HeyPCB/whisker/cad/board_on_cradle_under.png

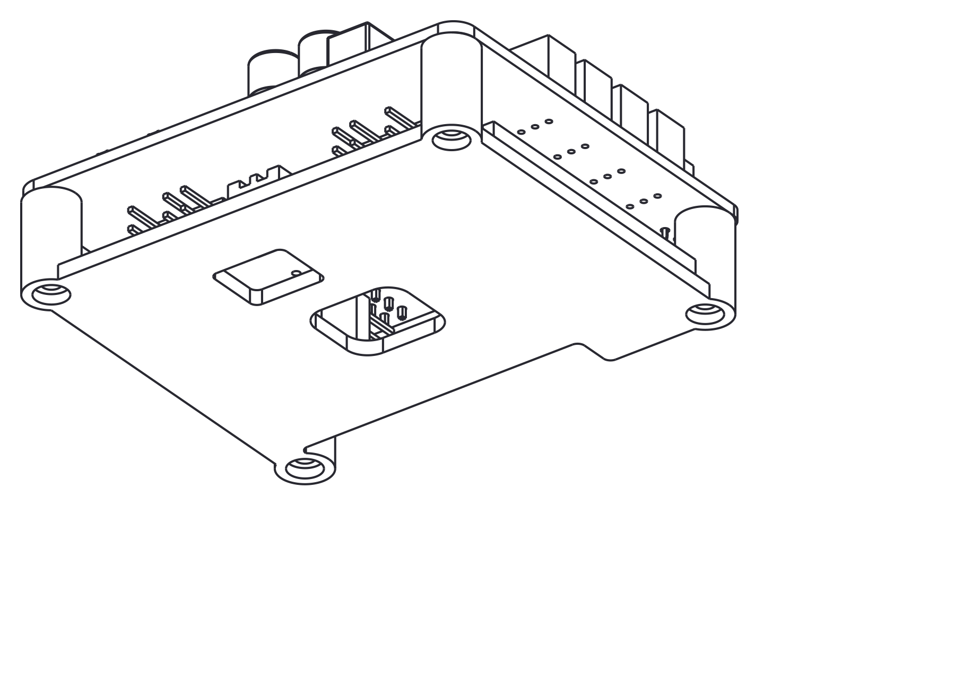
cad/board_on_cradle_under.png
