HeyPCB/whisker/cad/cradle_iso.png

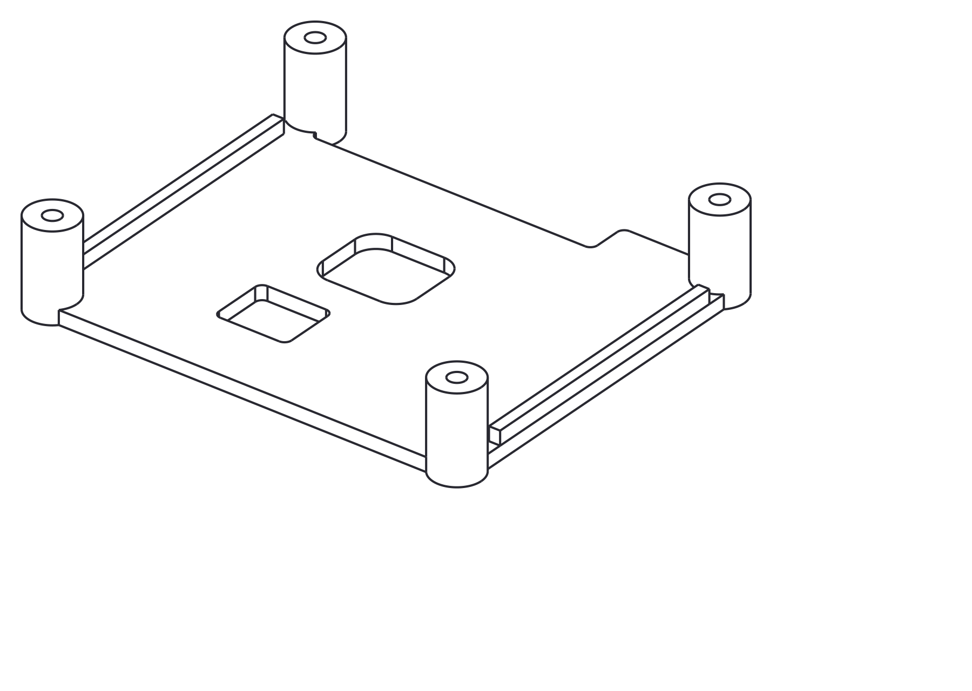
cad/cradle_iso.png
