HeyPCB/whisker/cad/cradle_top.png

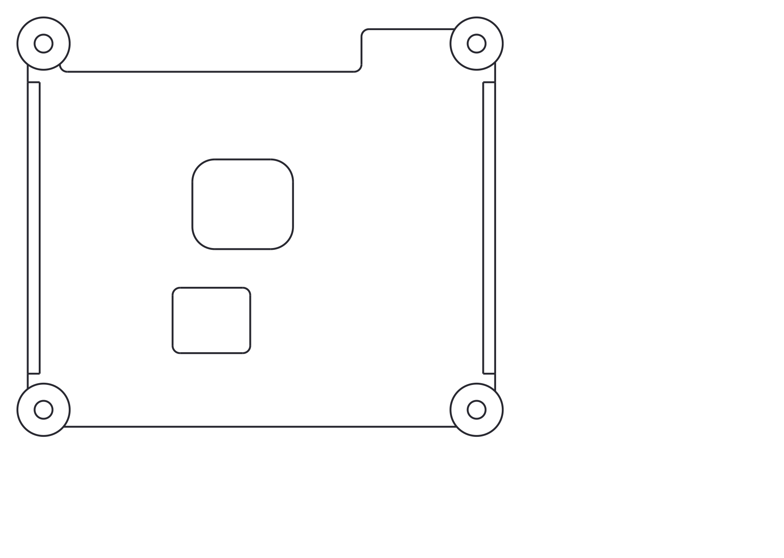
cad/cradle_top.png
