HeyPCB/whisker/cad/fit_end.png

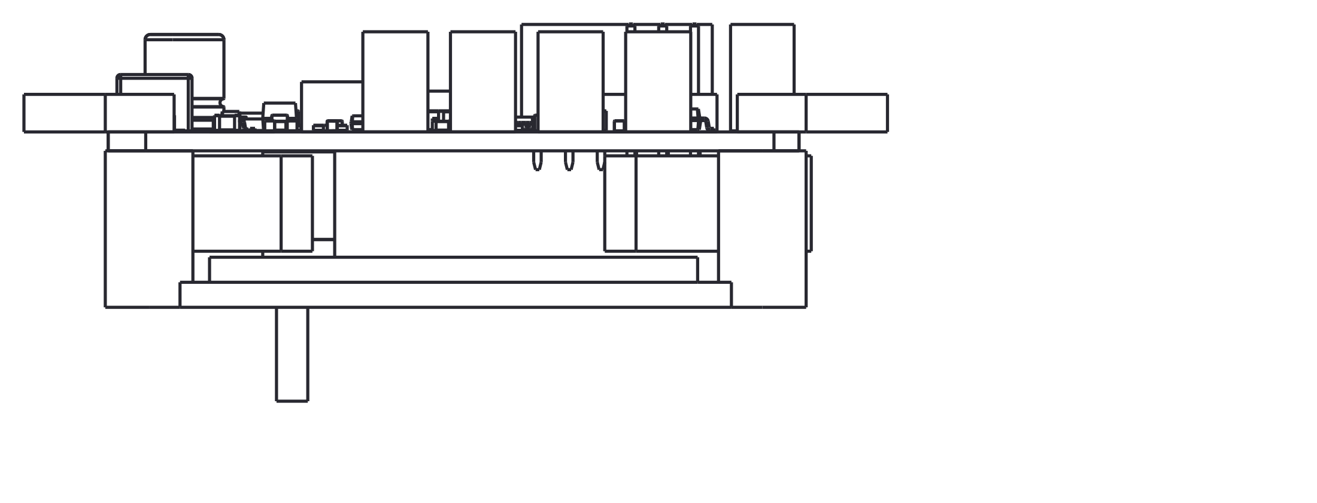
cad/fit_end.png
