HeyPCB/whisker/cad/fit_iso.png

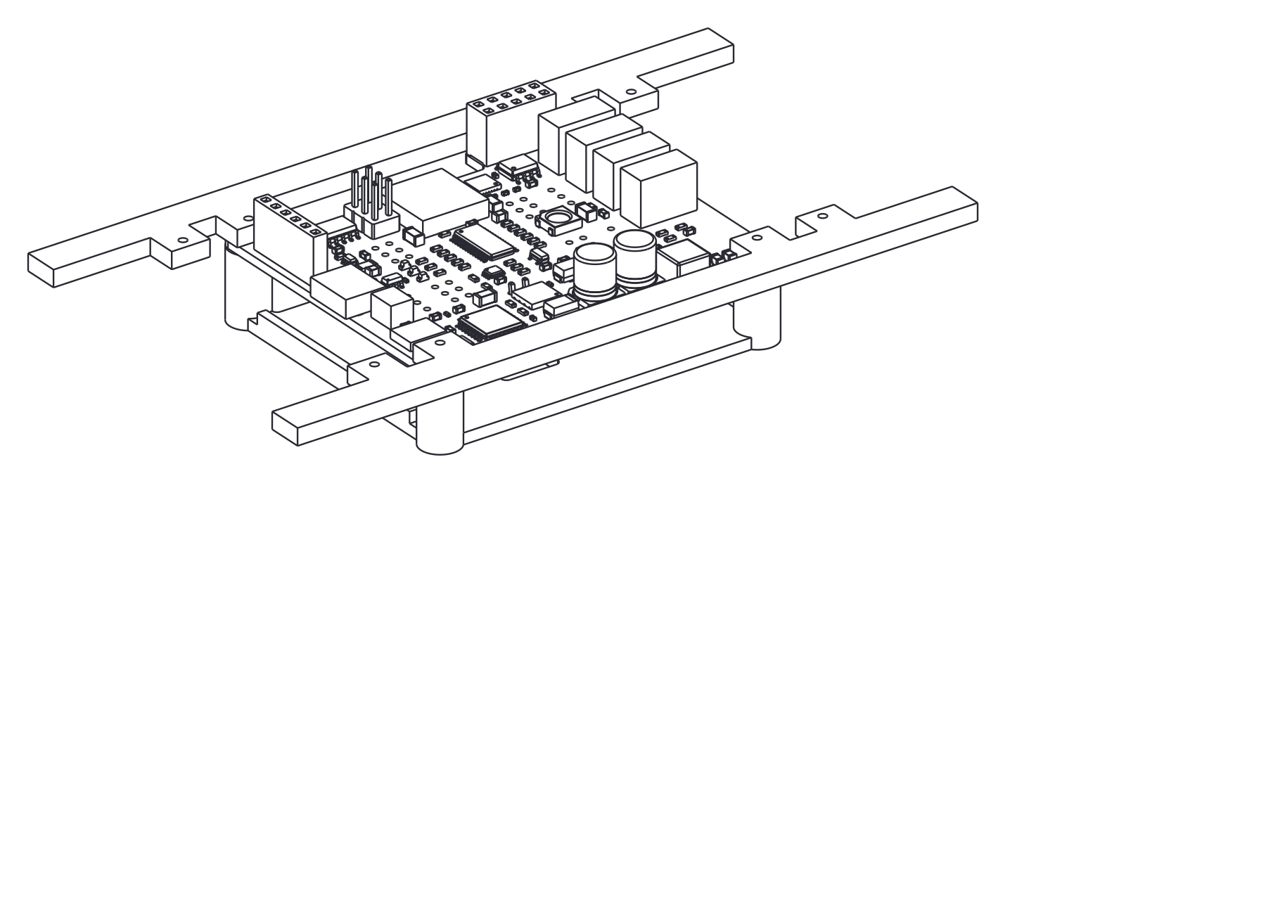
cad/fit_iso.png
