HeyPCB/whisker/cad/fit_side.png

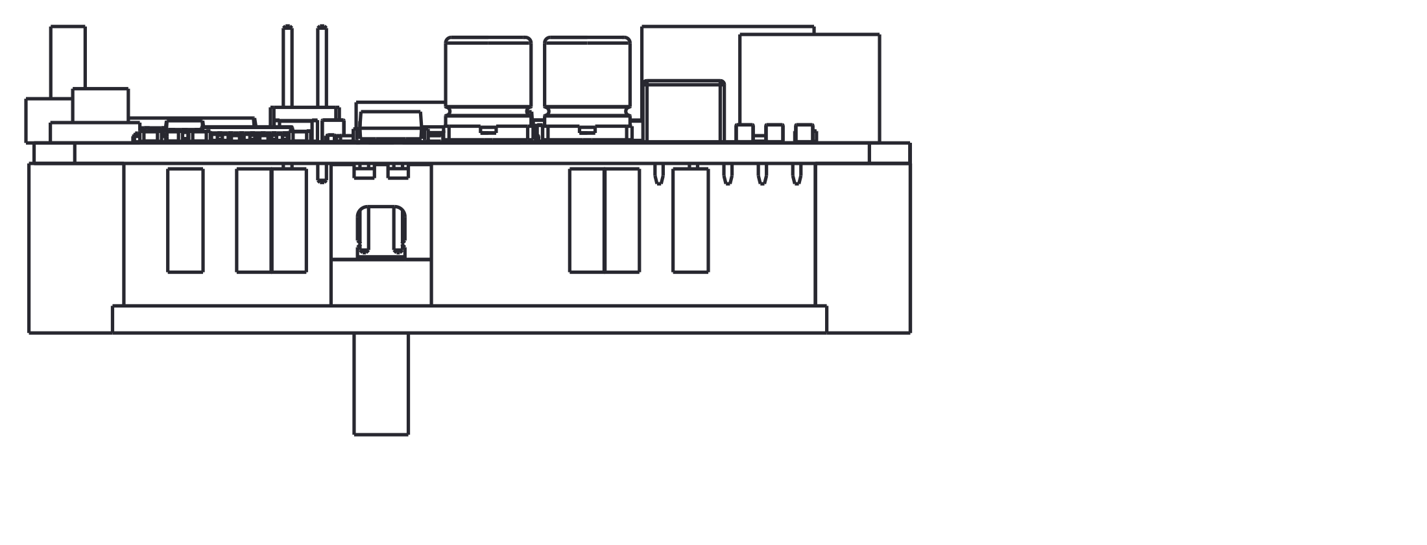
cad/fit_side.png
