HeyPCB/whisker/media/bottom.png

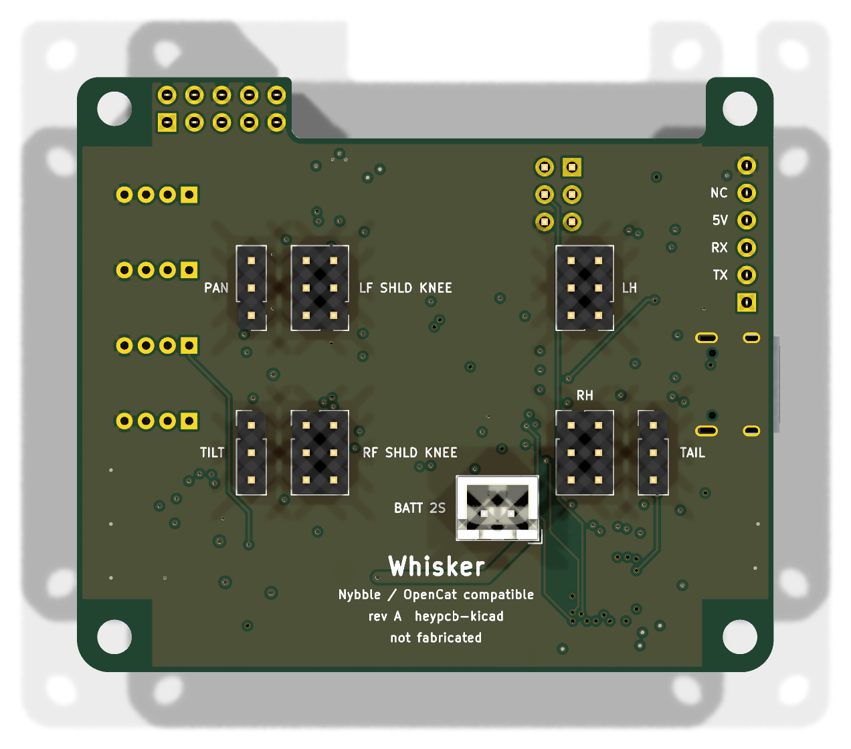
media/bottom.png
