HeyPCB/whisker/media/top.png

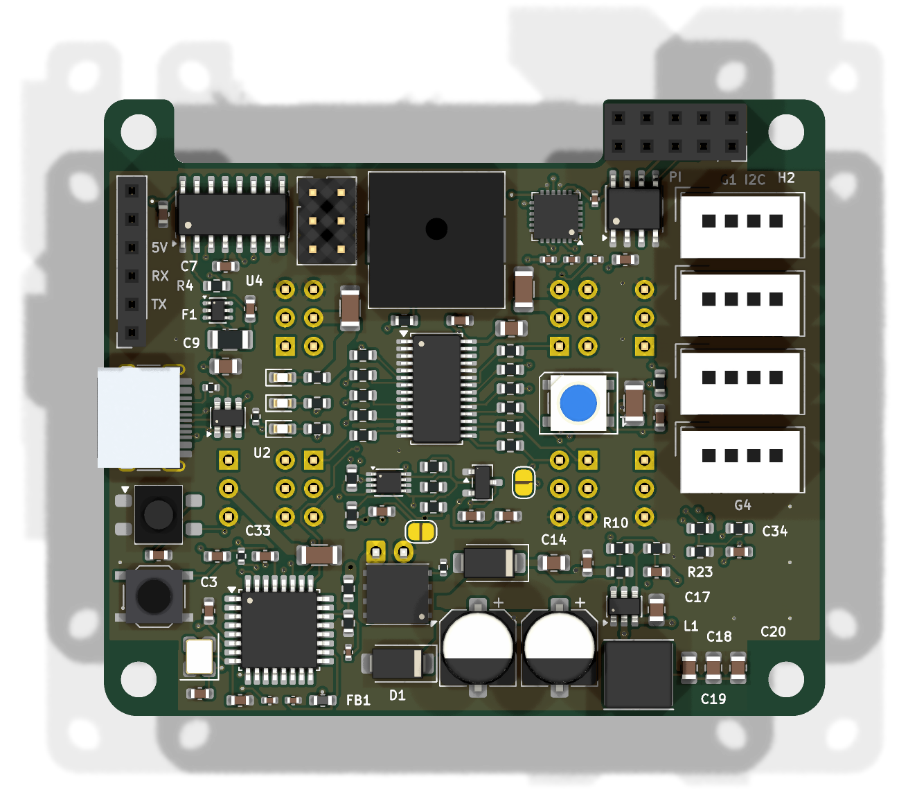
media/top.png
