HeyPCB/whisker/fab/whisker_bom.csv

Reference | Value | Footprint | MPN | LCSC | Qty
BZ1 | PKLCS1212E4001 | Buzzer_Beeper:Buzzer_Murata_PKLCS1212E | PKLCS1212E4001-R1 | C113159 | 1
C1,C2 | 12pF | Capacitor_SMD:C_0603_1608Metric | CL10C120JB8NNNC | C38523 | 2
C3,C6,C7,C8,C16,C17,C23,C24,C31,C32,C33,C34 | 100nF | Capacitor_SMD:C_0603_1608Metric | CC0603KRX7R9BB104 | C14663 | 12
C4,C5,C13,C26,C28,C30 | 100nF | Capacitor_SMD:C_0402_1005Metric | CL05B104KO5NNNC | C1525 | 6
C9,C25 | 10uF | Capacitor_SMD:C_0805_2012Metric | CL21A106KAYNNNE | C15850 | 2
C10,C21,C22 | 1uF | Capacitor_SMD:C_0603_1608Metric | CL10A105KB8NNNC | C15849 | 3
C11,C12 | 330uF 25V | Capacitor_SMD:CP_Elec_6.3x7.7 | 189RV0016 | C7471878 | 2
C14,C15,C18,C19,C20 | 22uF | Capacitor_SMD:C_0805_2012Metric | CL21A226MAQNNNE | C45783 | 5
C27 | 10nF | Capacitor_SMD:C_0402_1005Metric | CL05B103KB5NNNC | C15195 | 1
C29 | 2.2nF | Capacitor_SMD:C_0603_1608Metric | 0603B222K500NT | C1604 | 1
C35,C36,C37,C38 | 10uF | Capacitor_SMD:C_1206_3216Metric | CL31A106KBHNNNE | C13585 | 4
D1 | SMAJ10A | Diode_SMD:D_SMA | SMAJ10A | C908764 | 1
D2 | SS34 | Diode_SMD:D_SMA | SS34 | C8678 | 1
D3 | Orange (BAT) | LED_SMD:LED_0603_1608Metric | XL-1608UOC-06 | C965800 | 1
D4 | WS2812B | LED_SMD:LED_WS2812B_PLCC4_5.0x5.0mm_P3.2mm | WS2812B-B/T | C2761795 | 1
D5 | Green (D3) | LED_SMD:LED_0603_1608Metric | KT-0603G | C12624 | 1
D6 | Blue (5V) | LED_SMD:LED_0603_1608Metric | NCD0603B1 | C84266 | 1
F1 | 500mA | Fuse:Fuse_1206_3216Metric | 1206L050/30NR | C7542947 | 1
FB1 | 120R@100MHz | Inductor_SMD:L_0603_1608Metric | BLM18PG121SN1D | C14709 | 1
J1 | ICSP | Connector_PinHeader_2.54mm:PinHeader_2x03_P2.54mm_Vertical | PZ254V-12-6P | C492420 | 1
J2 | USB-C | Connector_USB:USB_C_Receptacle_HRO_TYPE-C-31-M-12 | TYPE-C-31-M-12 | C165948 | 1
J3 | BATT 2S | Connector_JST:JST_XH_B2B-XH-A_1x02_P2.50mm_Vertical | B2B-XH-A(LF)(SN) | C158012 | 1
J4,J5,J6,J7 | GROVE | Connector:NS-Tech_Grove_1x04_P2mm_Vertical | ZX-HY2.0-4PZZ | C7429580 | 4
J8 | SERIAL | Connector_PinSocket_2.54mm:PinSocket_1x06_P2.54mm_Vertical | 2.54-1*6P母 | C40877 | 1
J9 | RPI 1-10 | Connector_PinSocket_2.54mm:PinSocket_2x05_P2.54mm_Vertical | PM254V-12-10P-H85 | C492399 | 1
J10,J14,J16 | SERVO (3-row R/A) | Connector_PinHeader_2.54mm:PinHeader_1x03_P2.54mm_Vertical | PZ254-3-03-W-2.5-G0 | C7429379 | 3
J11,J12,J13,J15 | SERVO x2 (3-row R/A) | Connector_PinHeader_2.54mm:PinHeader_2x03_P2.54mm_Vertical | PZ254-3-03-W-2.5-G0 | C7429379 | 4
L1 | 4.7uH | Inductor_SMD:L_Sunlord_SWPA6045S | SWPA6045S4R7MT | C78804 | 1
Q1 | AON6411 | Package_DFN_QFN:AO_DFN-8-1EP_5.55x5.2mm_P1.27mm_EP4.12x4.6mm | AON6411 | C81007 | 1
R1,R5 | 10k | Resistor_SMD:R_0402_1005Metric | 0402WGF1002TCE | C25744 | 2
R2,R3 | 5.1k | Resistor_SMD:R_0402_1005Metric | 0402WGF5101TCE | C25905 | 2
R4,R19,R20,R21,R22,R24,R25,R26,R27,R28,R29,R30,R31,R32,R33,R34 | 1k | Resistor_SMD:R_0603_1608Metric | 0603WAF1001T5E | C21190 | 16
R6 | 4.7k | Resistor_SMD:R_0603_1608Metric | 0603WAF4701T5E | C23162 | 1
R7,R8 | 20k | Resistor_SMD:R_0603_1608Metric | 0603WAF2002T5E | C4184 | 2
R9 | 82k | Resistor_SMD:R_0603_1608Metric | 0603WAF8202T5E | C23254 | 1
R10 | 15k | Resistor_SMD:R_0603_1608Metric | 0603WAF1502T5E | C22809 | 1
R11 | 100k | Resistor_SMD:R_0603_1608Metric | 0603WAF1003T5E | C25803 | 1
R12 | 200k | Resistor_SMD:R_0603_1608Metric | 0603WAF2003T5E | C25811 | 1
R13,R14,R15,R16 | 2.2k | Resistor_SMD:R_0603_1608Metric | 0603WAF2201T5E | C4190 | 4
R17 | 100 | Resistor_SMD:R_0603_1608Metric | 0603WAF1000T5E | C22775 | 1
R18 | 330 | Resistor_SMD:R_0603_1608Metric | 0603WAF3300T5E | C23138 | 1
R23 | 2k | Resistor_SMD:R_0603_1608Metric | 0603WAF2001T5E | C22975 | 1
SW1 | RESET | Button_Switch_SMD:SW_Push_1P1T_XKB_TS-1187A | TS-1187A-B-A-B | C318884 | 1
U1 | ATmega328P-AU | Package_QFP:TQFP-32_7x7mm_P0.8mm | ATMEGA328P-AU | C14877 | 1
U2 | USBLC6-2SC6 | Package_TO_SOT_SMD:SOT-23-6 | USBLC6-2SC6 | C7519 | 1
U3 | CH340C | Package_SO:SOIC-16_3.9x9.9mm_P1.27mm | CH340C | C84681 | 1
U4 | LM66100 | Package_TO_SOT_SMD:SOT-363_SC-70-6 | LM66100DCKR | C2869734 | 1
U5 | TPS563201 | Package_TO_SOT_SMD:SOT-23-6 | TPS563201DDCR | C116592 | 1
U6 | XC6206P332MR | Package_TO_SOT_SMD:SOT-23-3 | XC6206P332MR-G | C5446 | 1
U7 | PCA9306 | Package_SO:VSSOP-8_2.3x2mm_P0.5mm | PCA9306DCUR | C33196 | 1
U8 | PCA9685PW | Package_SO:TSSOP-28_4.4x9.7mm_P0.65mm | PCA9685PW,118 | C2678753 | 1
U9 | MPU-6050 | Sensor_Motion:InvenSense_QFN-24_4x4mm_P0.5mm | MPU-6050 | C24112 | 1
U10 | AT24C64D | Package_SO:SOIC-8_3.9x4.9mm_P1.27mm | AT24C64D-SSHM-T | C6487 | 1
U11 | IRM-H638T | OptoDevice:Everlight_IRM-H6xxT | IRM-H638T/TR2 | C91447 | 1
Y1 | 16MHz | Crystal:Crystal_SMD_3225-4Pin_3.2x2.5mm | X322516MLB4SI | C13738 | 1
