HeyPCB/whisker/cad/whisker_with_cradle.step

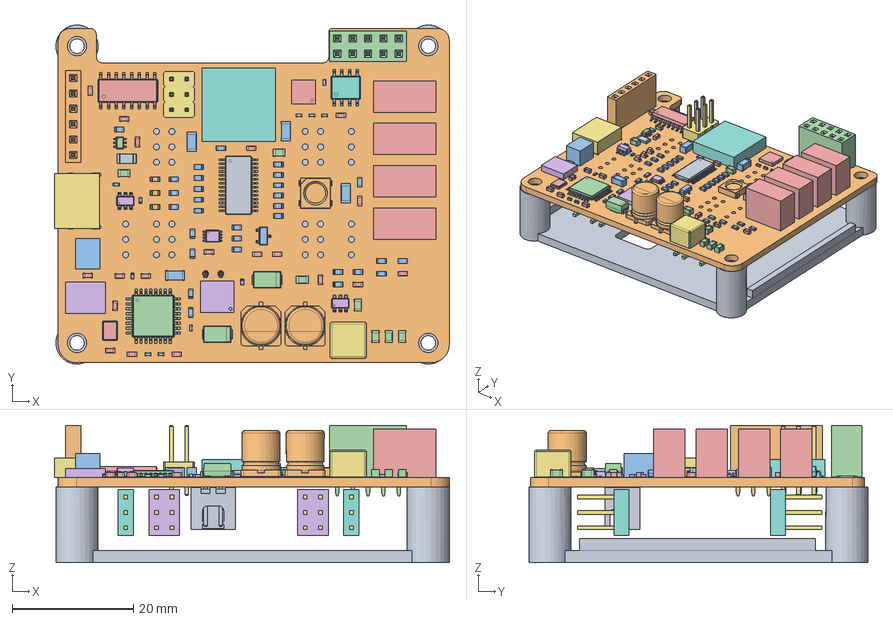
[picture p12: CAD file, 2026-10-03]
cad/whisker_with_cradle.step
65.2 x 56.0 x 22.6 mm
