HeyPCB/whisker/fab/whisker.step

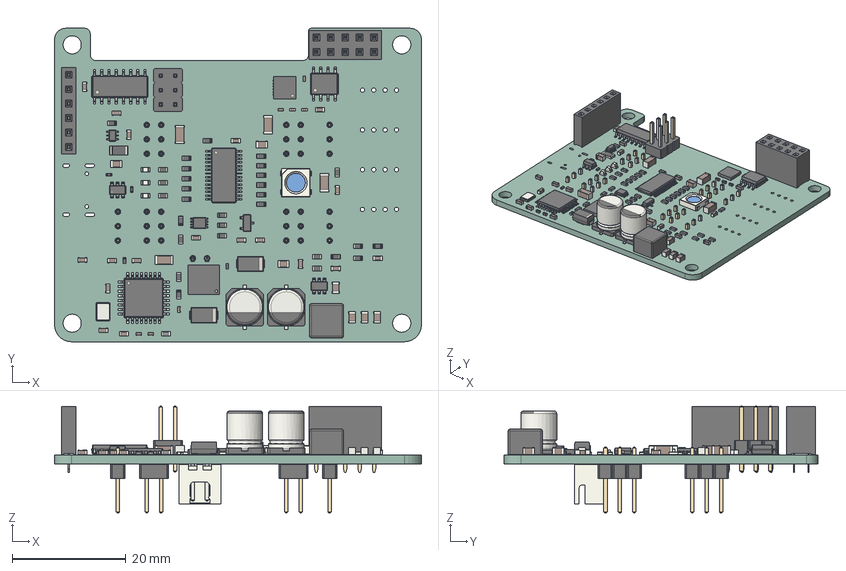
[picture p13: CAD file, 2026-10-03]
fab/whisker.step
64.6 x 55.2 x 18.8 mm
R_0603_1608Metric x 30
TQFP-32_7x7mm_P0.8mm
SOT-23-6 x 2
a6c163e6-8551-11ed-a139-00155d22e2d7_part
a6c16512-8551-11ed-a139-00155d22e2d7_part
a6c16594-8551-11ed-a139-00155d22e2d7_part
C_0402_1005Metric x 7
LED_WS2812B_PLCC4_50x50mm_P32mm
R_0402_1005Metric x 4
PinSocket_2x05_P2.54mm_Vertical
C_0603_1608Metric x 18
VSSOP-8_2.3x2mm_P0.5mm
Fuse_1206_3216Metric
LED_0603_1608Metric x 3
SOT-23-3
D_SMA x 2
L_0603_1608Metric
Crystal_SMD_3225-4Pin_3.2x2.5mm
PinHeader_2x03_P254mm_Vertical x 5
SOIC-8_3.9x4.9mm_P1.27mm
TSSOP-28_4.4x9.7mm_P0.65mm
CP_Elec_63x77 x 2
C_0805_2012Metric x 7
SOIC-16_3.9x9.9mm_P1.27mm
a4dc038a-92ba-11ed-bd60-83025610b399_part
a4dc038b-92ba-11ed-bd60-83025610b399_part
a4dc038c-92ba-11ed-bd60-83025610b399_part
a4dc038d-92ba-11ed-bd60-83025610b399_part
PinSocket_1x06_P2.54mm_Vertical
C_1206_3216Metric x 4
SOT-363_SC-70-6
QFN-24-1EP_4x4mm_P0.5mm_EP2.7x2.7mm
PinHeader_1x03_P254mm_Vertical x 3
JST_B2B_XH_A
whisker_PCB
