HeyPCB/whisker/cad/whisker_cradle.step

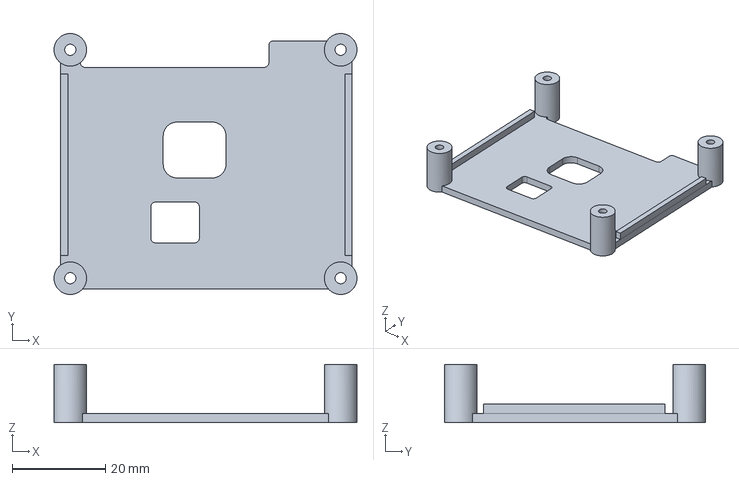
[picture p14: CAD file, 2026-10-03]
cad/whisker_cradle.step
65.0 x 56.0 x 12.5 mm
