HeyPCB/whisker/(list of files, cad)

Other CAD files:
cad/whisker_cradle.stl
