HeyPCB/whisker/fab/whisker_schematic.pdf

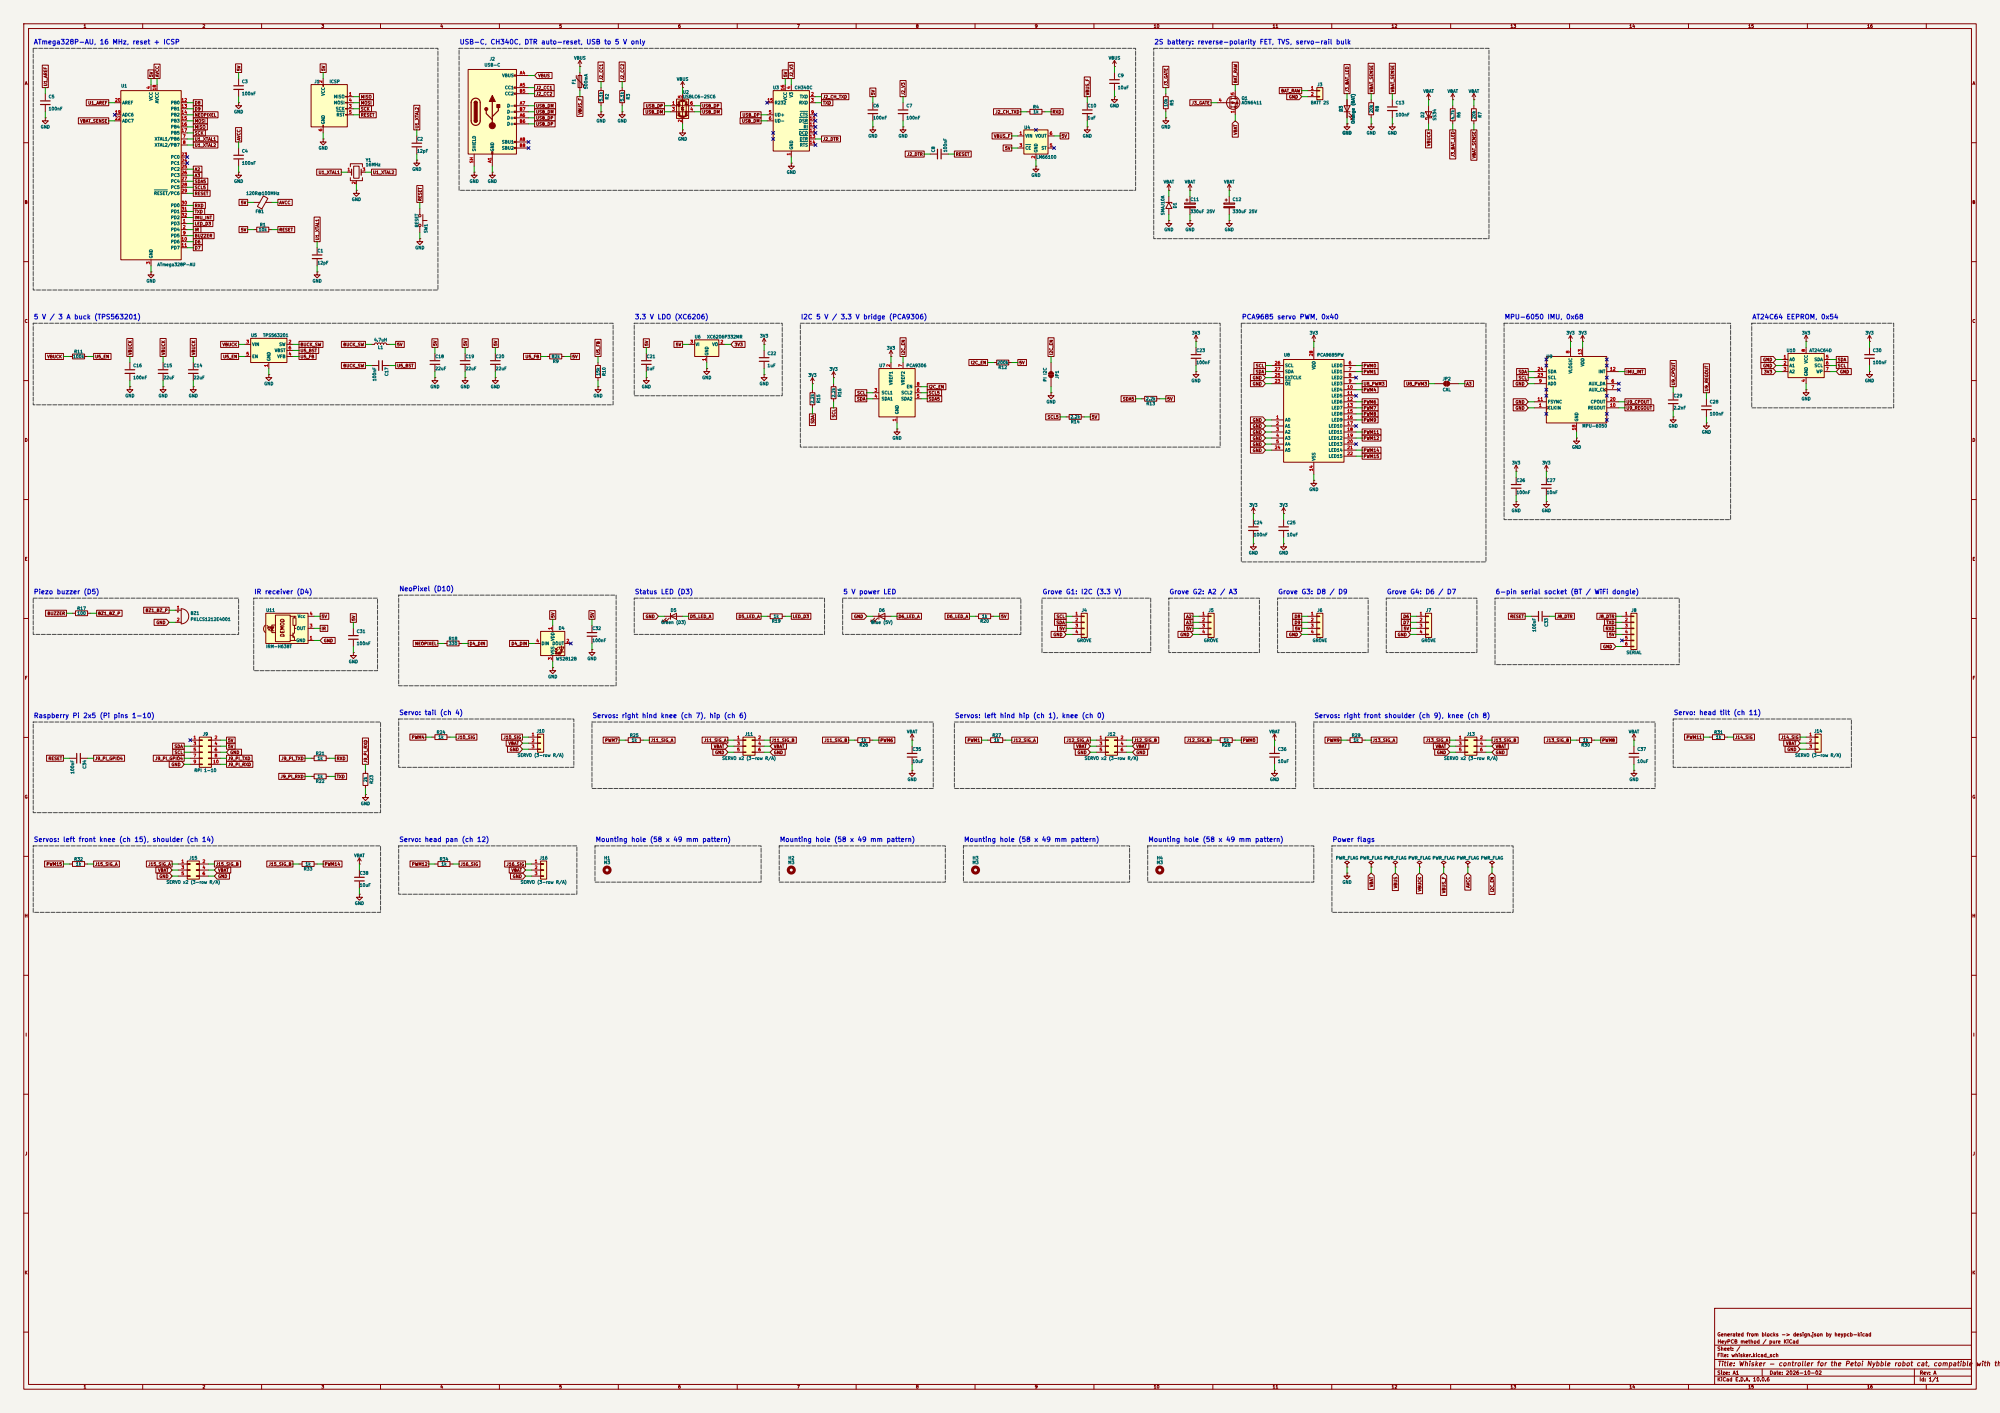
[picture p15: page 1]

ATmega328P-AU, 16 MHz, reset + ICSP

USB-C, CH340C, DTR auto-reset, USB to 5 V only
VBUS USB_DM

2S battery: reverse-polarity FET, TVS, servo-rail bulk
VBAT VBUS_F 5V

4 UD+ 5 UD- 6 CTS 9 DSR 10 RI 11 DCD 12 DTR 13 RTS 14 R232 15 VCC U3 16CH340C

Raspberry Pi 2x5 (Pi pins 1-10)

Servos: right front shoulder (ch 9), knee (ch 8)

Servo: head tilt (ch 11)

Servos: left front knee (ch 15), shoulder (ch 14)

Servo: head pan (ch 12)

Mounting hole (58 x 49 mm pattern)

Generated from blocks -> design.json by heypcb-kicad
HeyPCB method / pure KiCad
Sheet: /
File: whisker.kicad_sch
Title: Whisker - controller for the Petoi Nybble robot cat, compatible with the OpenCat firmware

Size: A1 | Rev: A
KiCad E.D.A. 10.0.6 | Id: 1/1
