HeyPCB/whisker/kicad/whisker.kicad_pcb

## KiCad design kicad/whisker.kicad_pcb (2026-10-03)

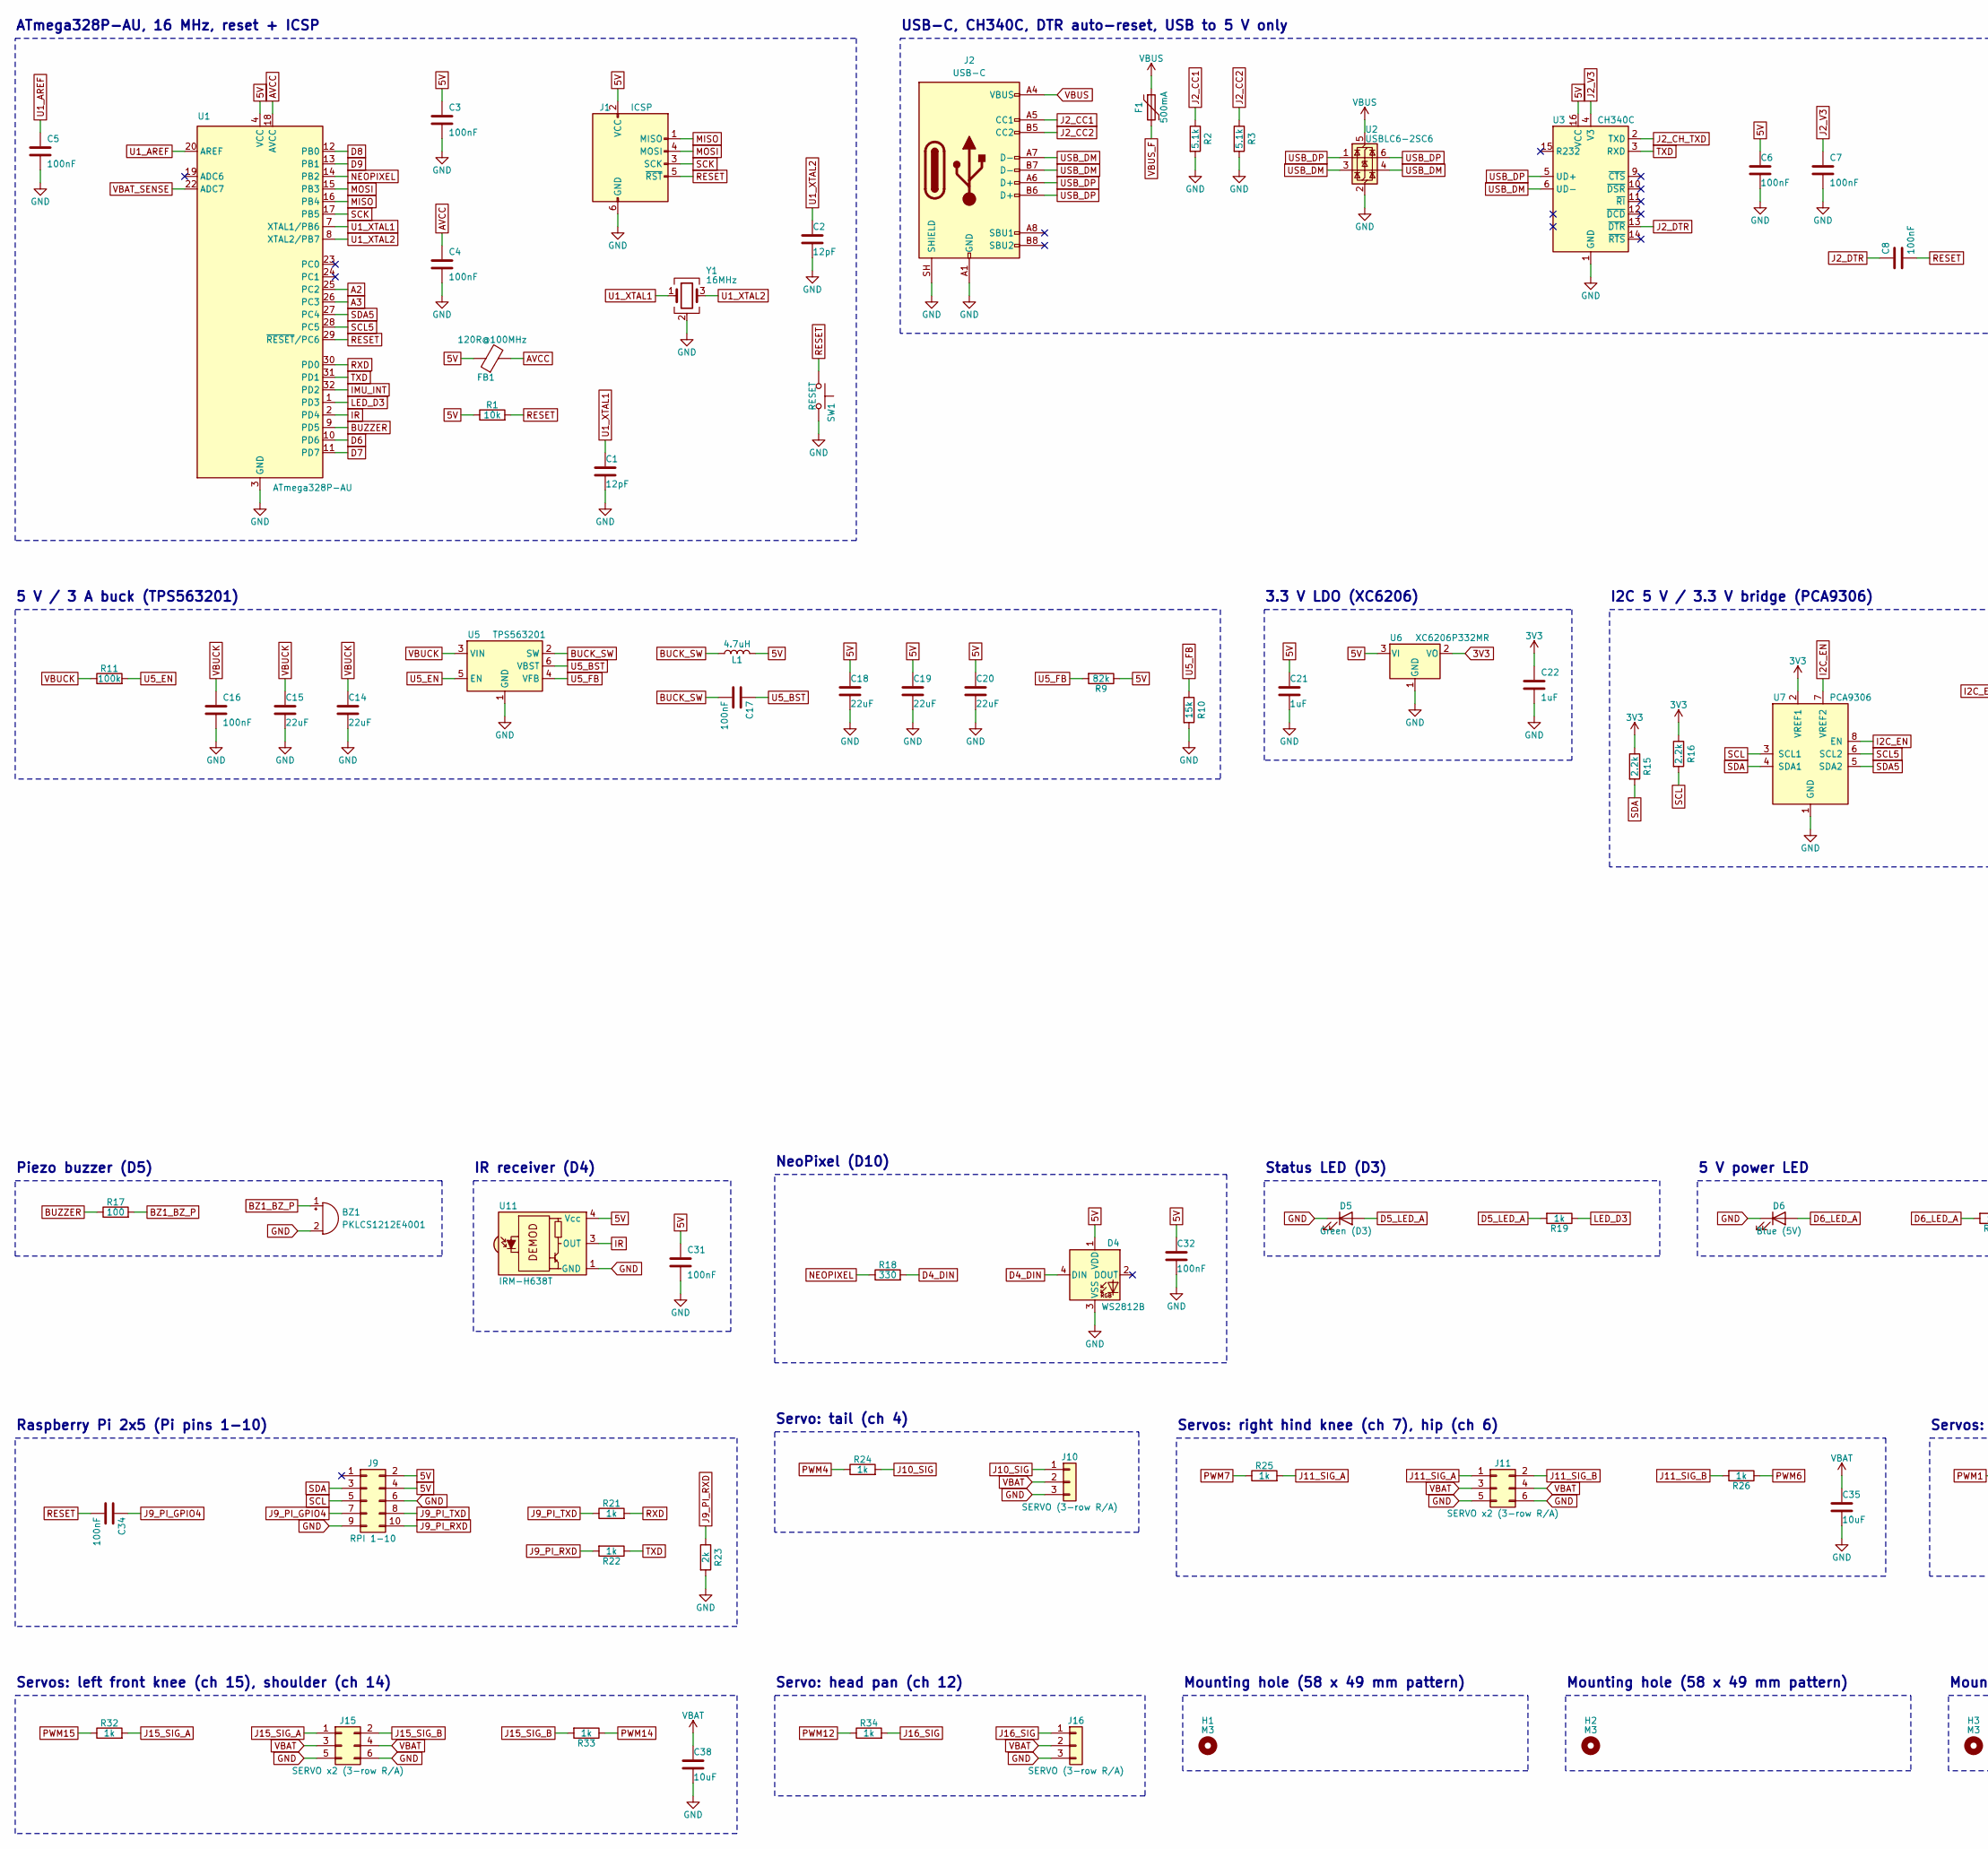
[picture p16: schematic whisker.kicad_sch, Whisker - controller for the Petoi Nybble robot cat, compat…, part in row 1, column 1]

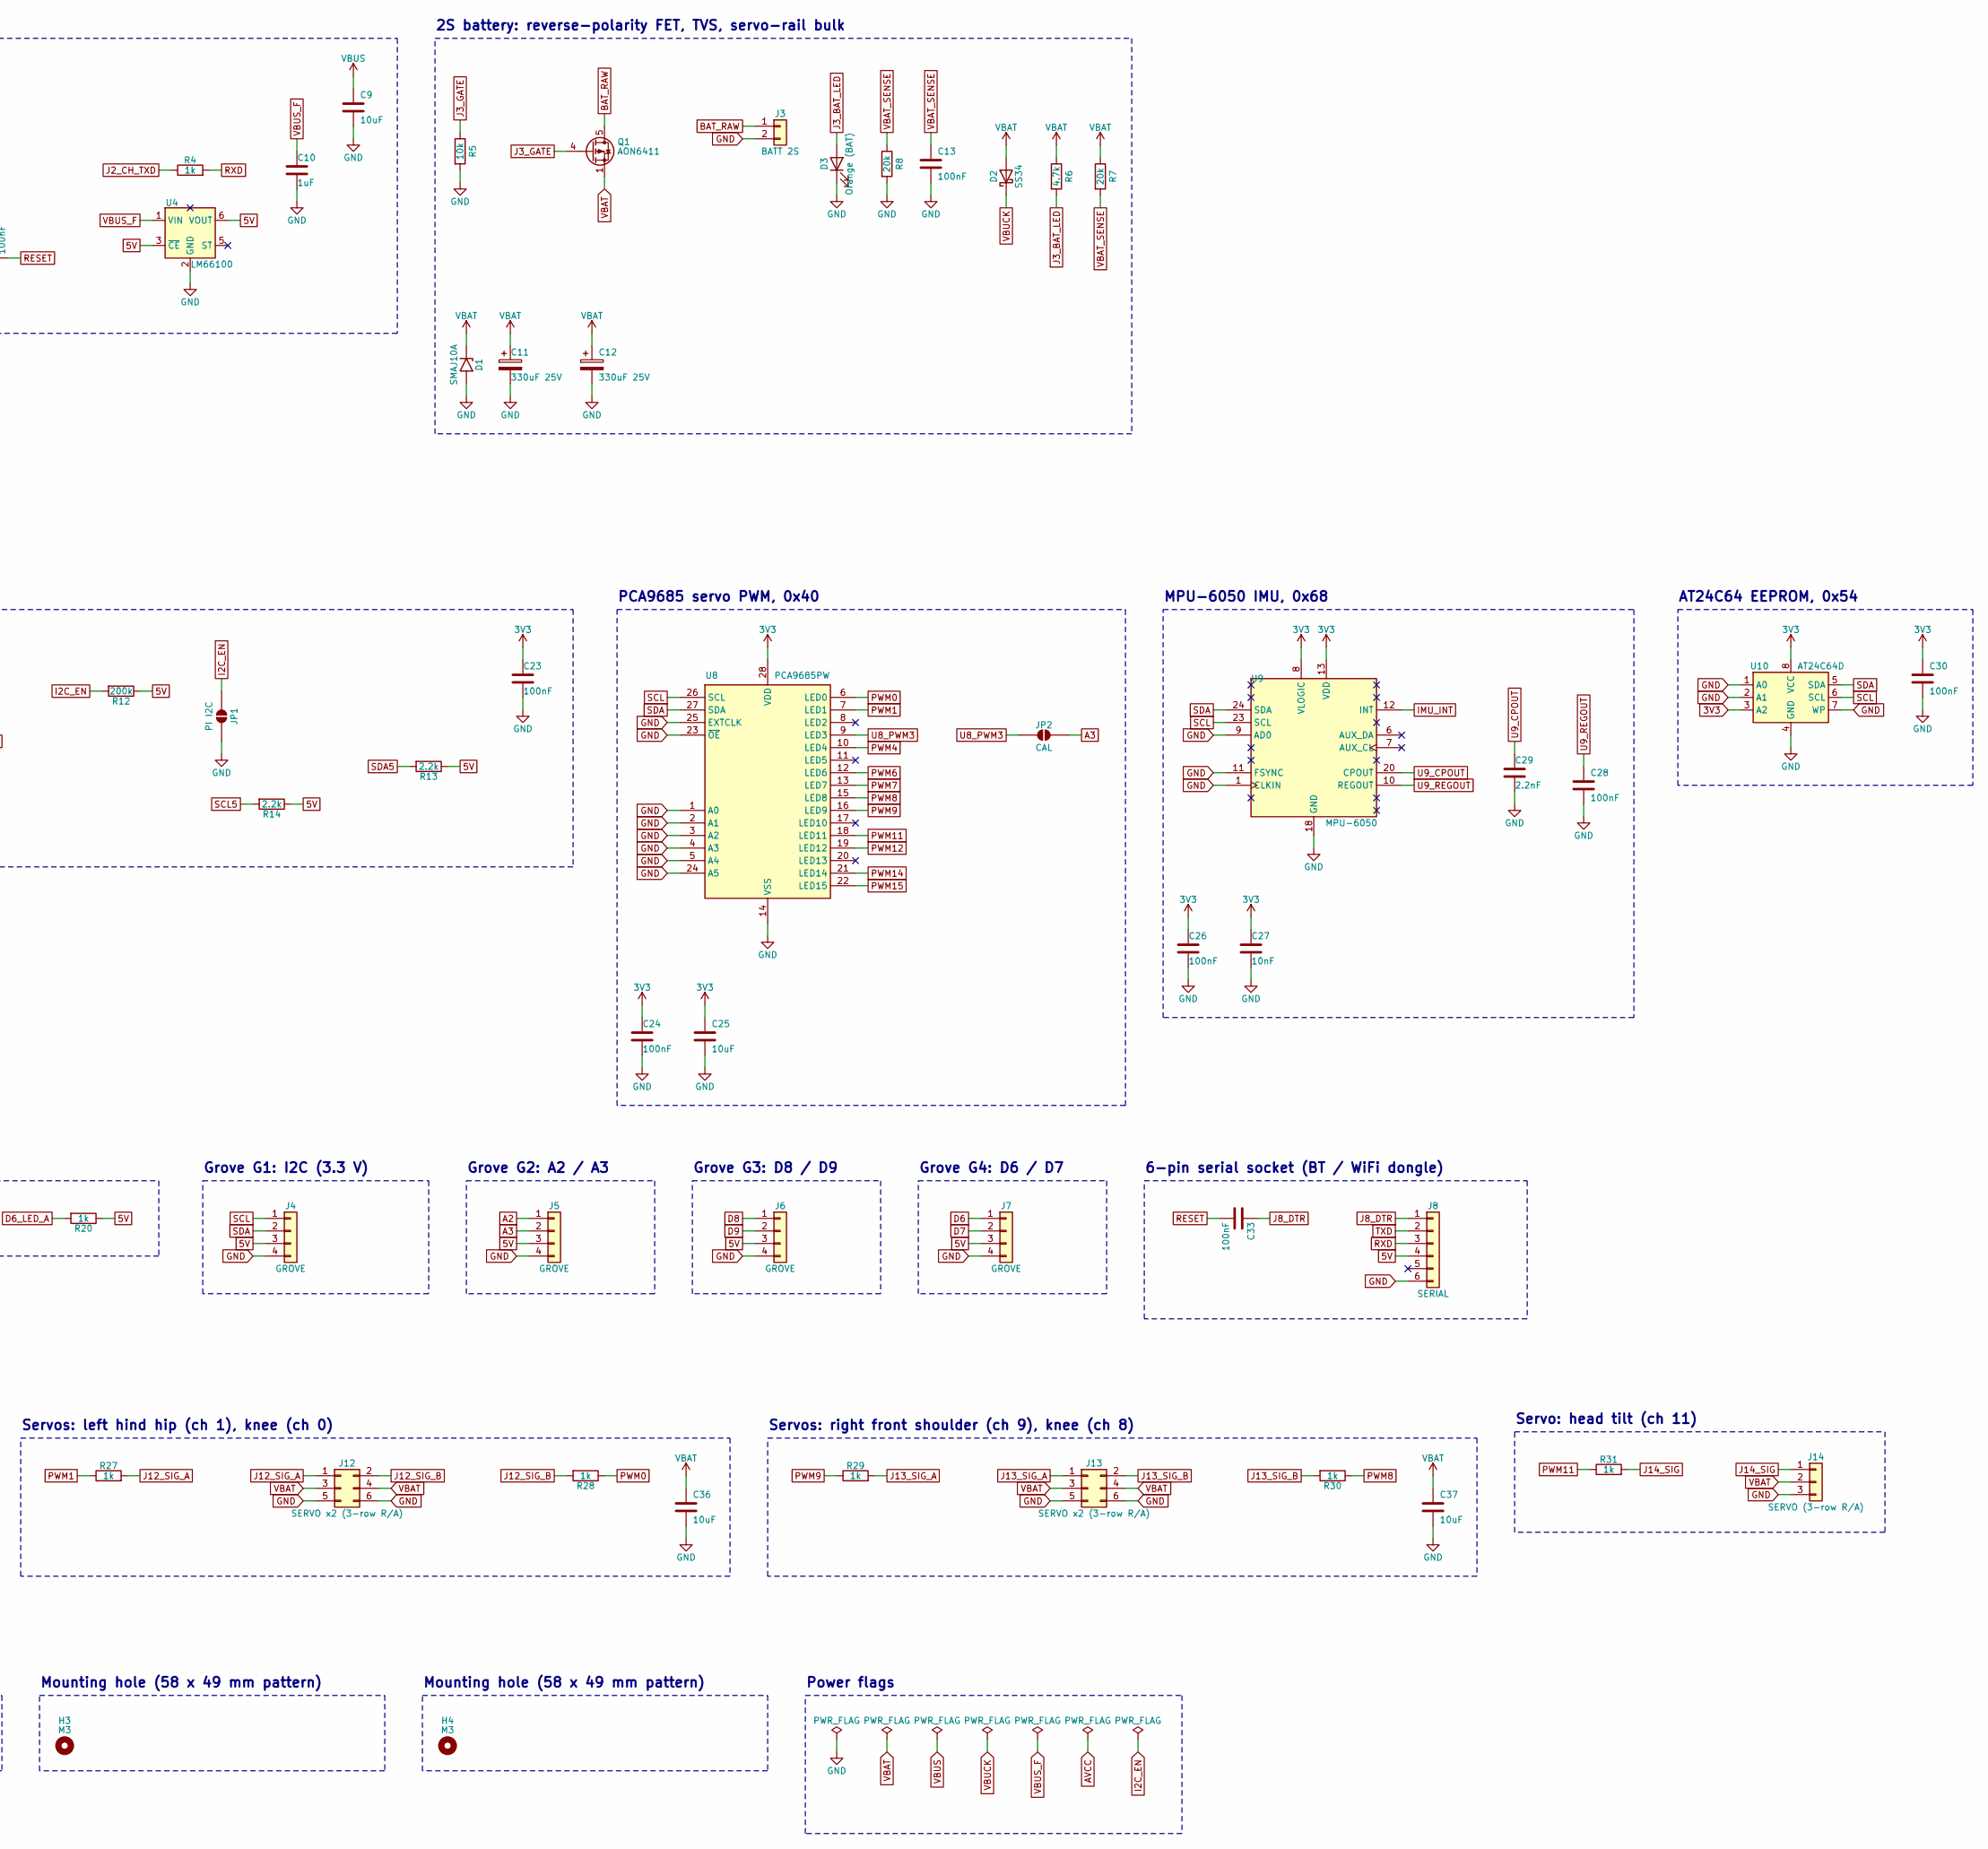
[picture p17: schematic whisker.kicad_sch, Whisker - controller for the Petoi Nybble robot cat, compat…, part in row 1, column 2]

Parts:
BZ1: PKLCS1212E4001; Buzzer_Murata_PKLCS1212E; MPN PKLCS1212E4001-R1; LCSC C113159
C1, C2: 12pF; C_0603_1608Metric; MPN CL10C120JB8NNNC; LCSC C38523
C3, C6, C7, C8, C16, C17, C23, C24, C31, C32, C33, C34: 100nF; C_0603_1608Metric; MPN CC0603KRX7R9BB104; LCSC C14663
C4, C5, C13, C26, C28, C30: 100nF; C_0402_1005Metric; MPN CL05B104KO5NNNC; LCSC C1525
C9, C25: 10uF; C_0805_2012Metric; MPN CL21A106KAYNNNE; LCSC C15850
C10, C21, C22: 1uF; C_0603_1608Metric; MPN CL10A105KB8NNNC; LCSC C15849
C11, C12: 330uF 25V; CP_Elec_6.3x7.7; MPN 189RV0016; LCSC C7471878
C14, C15, C18, C19, C20: 22uF; C_0805_2012Metric; MPN CL21A226MAQNNNE; LCSC C45783
C27: 10nF; C_0402_1005Metric; MPN CL05B103KB5NNNC; LCSC C15195
C29: 2.2nF; C_0603_1608Metric; MPN 0603B222K500NT; LCSC C1604
C35, C36, C37, C38: 10uF; C_1206_3216Metric; MPN CL31A106KBHNNNE; LCSC C13585
D1: SMAJ10A; D_SMA; MPN SMAJ10A; LCSC C908764
D2: SS34; D_SMA; MPN SS34; LCSC C8678
D3: Orange (BAT); LED_0603_1608Metric; MPN XL-1608UOC-06; LCSC C965800
D4: WS2812B; LED_WS2812B_PLCC4_5.0x5.0mm_P3.2mm; MPN WS2812B-B/T; LCSC C2761795
D5: Green (D3); LED_0603_1608Metric; MPN KT-0603G; LCSC C12624
D6: Blue (5V); LED_0603_1608Metric; MPN NCD0603B1; LCSC C84266
F1: 500mA; Fuse_1206_3216Metric; MPN 1206L050/30NR; LCSC C7542947
FB1: 120R@100MHz; L_0603_1608Metric; MPN BLM18PG121SN1D; LCSC C14709
H1, H2, H3, H4: M3; MountingHole_3.2mm_M3_ISO14580
J1: ICSP; PinHeader_2x03_P2.54mm_Vertical; MPN PZ254V-12-6P; LCSC C492420
J2: USB-C; USB_C_Receptacle_HRO_TYPE-C-31-M-12; MPN TYPE-C-31-M-12; LCSC C165948
J3: BATT 2S; JST_XH_B2B-XH-A_1x02_P2.50mm_Vertical; MPN B2B-XH-A(LF)(SN); LCSC C158012
J4, J5, J6, J7: GROVE; NS-Tech_Grove_1x04_P2mm_Vertical; MPN ZX-HY2.0-4PZZ; LCSC C7429580
J8: SERIAL; PinSocket_1x06_P2.54mm_Vertical; MPN 2.54-1*6P母; LCSC C40877
J9: RPI 1-10; PinSocket_2x05_P2.54mm_Vertical; MPN PM254V-12-10P-H85; LCSC C492399
J10, J14, J16: SERVO (3-row R/A); PinHeader_1x03_P2.54mm_Vertical; MPN PZ254-3-03-W-2.5-G0; LCSC C7429379
J11, J12, J13, J15: SERVO x2 (3-row R/A); PinHeader_2x03_P2.54mm_Vertical; MPN PZ254-3-03-W-2.5-G0; LCSC C7429379
JP1: PI I2C; SolderJumper-2_P1.3mm_Open_RoundedPad1.0x1.5mm
JP2: CAL; SolderJumper-2_P1.3mm_Open_RoundedPad1.0x1.5mm
L1: 4.7uH; L_Sunlord_SWPA6045S; MPN SWPA6045S4R7MT; LCSC C78804
Q1: AON6411; AO_DFN-8-1EP_5.55x5.2mm_P1.27mm_EP4.12x4.6mm; MPN AON6411; LCSC C81007
R1, R5: 10k; R_0402_1005Metric; MPN 0402WGF1002TCE; LCSC C25744
R2, R3: 5.1k; R_0402_1005Metric; MPN 0402WGF5101TCE; LCSC C25905
R4, R19, R20, R21, R22, R24, R25, R26, R27, R28, R29, R30, R31, R32, R33, R34: 1k; R_0603_1608Metric; MPN 0603WAF1001T5E; LCSC C21190
R6: 4.7k; R_0603_1608Metric; MPN 0603WAF4701T5E; LCSC C23162
R7, R8: 20k; R_0603_1608Metric; MPN 0603WAF2002T5E; LCSC C4184
R9: 82k; R_0603_1608Metric; MPN 0603WAF8202T5E; LCSC C23254
R10: 15k; R_0603_1608Metric; MPN 0603WAF1502T5E; LCSC C22809
R11: 100k; R_0603_1608Metric; MPN 0603WAF1003T5E; LCSC C25803
R12: 200k; R_0603_1608Metric; MPN 0603WAF2003T5E; LCSC C25811
R13, R14, R15, R16: 2.2k; R_0603_1608Metric; MPN 0603WAF2201T5E; LCSC C4190
R17: 100; R_0603_1608Metric; MPN 0603WAF1000T5E; LCSC C22775
R18: 330; R_0603_1608Metric; MPN 0603WAF3300T5E; LCSC C23138
R23: 2k; R_0603_1608Metric; MPN 0603WAF2001T5E; LCSC C22975
SW1: RESET; SW_Push_1P1T_XKB_TS-1187A; MPN TS-1187A-B-A-B; LCSC C318884
U1: ATmega328P-AU; TQFP-32_7x7mm_P0.8mm; MPN ATMEGA328P-AU; LCSC C14877
U2: USBLC6-2SC6; SOT-23-6; MPN USBLC6-2SC6; LCSC C7519
U3: CH340C; SOIC-16_3.9x9.9mm_P1.27mm; MPN CH340C; LCSC C84681
U4: LM66100; SOT-363_SC-70-6; MPN LM66100DCKR; LCSC C2869734
U5: TPS563201; SOT-23-6; MPN TPS563201DDCR; LCSC C116592
U6: XC6206P332MR; SOT-23-3; MPN XC6206P332MR-G; LCSC C5446
U7: PCA9306; VSSOP-8_2.3x2mm_P0.5mm; MPN PCA9306DCUR; LCSC C33196
U8: PCA9685PW; TSSOP-28_4.4x9.7mm_P0.65mm; MPN PCA9685PW,118; LCSC C2678753
U9: MPU-6050; InvenSense_QFN-24_4x4mm_P0.5mm; MPN MPU-6050; LCSC C24112
U10: AT24C64D; SOIC-8_3.9x4.9mm_P1.27mm; MPN AT24C64D-SSHM-T; LCSC C6487
U11: IRM-H638T; Everlight_IRM-H6xxT; MPN IRM-H638T/TR2; LCSC C91447
Y1: 16MHz; Crystal_SMD_3225-4Pin_3.2x2.5mm; MPN X322516MLB4SI; LCSC C13738

Connections:
3V3: C22.1, C23.1, C24.1, C25.1, C26.1, C27.1, C30.1, R15.1, R16.1, U6.2 (VO), U7.2 (VREF1), U8.28 (VDD), U9.8 (VLOGIC), U9.13 (VDD), U10.3 (A2), U10.8 (VCC)
5V: C3.1, C6.1, C18.1, C19.1, C20.1, C21.1, C31.1, C32.1, D4.1 (VDD), FB1.1, J1.2 (VCC), J4.3, J5.3, J6.3, J7.3, J8.4, J9.2, J9.4, L1.2, R1.1, R9.1, R12.1, R13.1, R14.1, R20.1, U1.4 (VCC), U1.6 (VCC), U3.16 (VCC), U4.3 (~CE), U4.6 (VOUT), U6.3 (VI), U11.4 (Vcc)
A2: J5.1, U1.25 (PC2)
A3: J5.2, JP2.2 (B), U1.26 (PC3)
AVCC: C4.1, FB1.2, U1.18 (AVCC)
BAT_RAW: J3.1, Q1.5 (D)
BUCK_SW: C17.2, L1.1, U5.2 (SW)
BUZZER: R17.1, U1.9 (PD5)
BZ1_BZ_P: BZ1.1 (+), R17.2
D4_DIN: D4.4 (DIN), R18.2
D5_LED_A: D5.2 (A), R19.2
D6: J7.1, U1.10 (PD6)
D6_LED_A: D6.2 (A), R20.2
D7: J7.2, U1.11 (PD7)
D8: J6.1, U1.12 (PB0)
D9: J6.2, U1.13 (PB1)
GND: BZ1.2 (-), C1.2, C2.2, C3.2, C4.2, C5.2, C6.2, C7.2, C9.2, C10.2, C11.2, C12.2, C13.2, C14.2, C15.2, C16.2, C18.2, C19.2, C20.2, C21.2, C22.2, C23.2, C24.2, C25.2, C26.2, C27.2, C28.2, C29.2, C30.2, C31.2, C32.2, C35.2, C36.2, C37.2, C38.2, D1.2 (A2), D3.1 (K), D4.3 (VSS), D5.1 (K), D6.1 (K), J1.6 (GND), J2.A1 (GND), J2.A12 (GND), J2.B1 (GND), J2.B12 (GND), J2.SH (SHIELD), J3.2, J4.4, J5.4, J6.4, J7.4, J8.6, J9.6, J9.9, J10.3, J11.5, J11.6, J12.5, J12.6, J13.5, J13.6, J14.3, J15.5, J15.6, J16.3, JP1.2 (B), R2.2, R3.2, R5.2, R8.2, R10.2, R23.2, SW1.2, U1.3 (GND), U1.5 (GND), U1.21 (GND), U2.2 (GND), U3.1 (GND), U4.2 (GND), U5.1 (GND), U6.1 (GND), U7.1 (GND), U8.1 (A0), U8.2 (A1), U8.3 (A2), U8.4 (A3), U8.5 (A4), U8.14 (VSS), U8.23 (~OE), U8.24 (A5), U8.25 (EXTCLK), U9.1 (CLKIN), U9.9 (AD0), U9.11 (FSYNC), U9.18 (GND), U10.1 (A0), U10.2 (A1), U10.4 (GND), U10.7 (WP), U11.1 (GND), U11.2 (GND), Y1.2 (G), Y1.4 (G)
I2C_EN: JP1.1 (A), R12.2, U7.7 (VREF2), U7.8 (EN)
IMU_INT: U1.32 (PD2), U9.12 (INT)
IR: U1.2 (PD4), U11.3 (OUT)
J2_CC1: J2.A5 (CC1), R2.1
J2_CC2: J2.B5 (CC2), R3.1
J2_CH_TXD: R4.1, U3.2 (TXD)
J2_DTR: C8.1, U3.13 (~DTR)
J2_V3: C7.1, U3.4 (V3)
J3_BAT_LED: D3.2 (A), R6.2
J3_GATE: Q1.4 (G), R5.1
J8_DTR: C33.1, J8.1
J9_PI_GPIO4: C34.1, J9.7
J9_PI_RXD: J9.10, R22.2, R23.1
J9_PI_TXD: J9.8, R21.1
J10_SIG: J10.1, R24.2
J11_SIG_A: J11.1, R25.2
J11_SIG_B: J11.2, R26.2
J12_SIG_A: J12.1, R27.2
J12_SIG_B: J12.2, R28.2
J13_SIG_A: J13.1, R29.2
J13_SIG_B: J13.2, R30.2
J14_SIG: J14.1, R31.2
J15_SIG_A: J15.1, R32.2
J15_SIG_B: J15.2, R33.2
J16_SIG: J16.1, R34.2
LED_D3: R19.1, U1.1 (PD3)
MISO: J1.1 (MISO), U1.16 (PB4)
MOSI: J1.4 (MOSI), U1.15 (PB3)
NEOPIXEL: R18.1, U1.14 (PB2)
PWM0: R28.1, U8.6 (LED0)
PWM1: R27.1, U8.7 (LED1)
PWM4: R24.1, U8.10 (LED4)
PWM6: R26.1, U8.12 (LED6)
PWM7: R25.1, U8.13 (LED7)
PWM8: R30.1, U8.15 (LED8)
PWM9: R29.1, U8.16 (LED9)
PWM11: R31.1, U8.18 (LED11)
PWM12: R34.1, U8.19 (LED12)
PWM14: R33.1, U8.21 (LED14)
PWM15: R32.1, U8.22 (LED15)
RESET: C8.2, C33.2, C34.2, J1.5 (~RST), R1.2, SW1.1, U1.29 (~RESET/PC6)
RXD: J8.3, R4.2, R21.2, U1.30 (PD0)
SCK: J1.3 (SCK), U1.17 (PB5)
SCL: J4.1, J9.5, R16.2, U7.3 (SCL1), U8.26 (SCL), U9.23 (SCL), U10.6 (SCL)
SCL5: R14.2, U1.28 (PC5), U7.6 (SCL2)
SDA: J4.2, J9.3, R15.2, U7.4 (SDA1), U8.27 (SDA), U9.24 (SDA), U10.5 (SDA)
SDA5: R13.2, U1.27 (PC4), U7.5 (SDA2)
TXD: J8.2, R22.1, U1.31 (PD1), U3.3 (RXD)
U1_AREF: C5.1, U1.20 (AREF)
U1_XTAL1: C1.1, U1.7 (XTAL1/PB6), Y1.1
U1_XTAL2: C2.1, U1.8 (XTAL2/PB7), Y1.3
U5_BST: C17.1, U5.6 (VBST)
U5_EN: R11.2, U5.5 (EN)
U5_FB: R9.2, R10.1, U5.4 (VFB)
U8_PWM3: JP2.1 (A), U8.9 (LED3)
U9_CPOUT: C29.1, U9.20 (CPOUT)
U9_REGOUT: C28.1, U9.10 (REGOUT)
USB_DM: J2.A7 (D-), J2.B7 (D-), U2.3 (I/O2), U2.4 (I/O2), U3.6 (UD-)
USB_DP: J2.A6 (D+), J2.B6 (D+), U2.1 (I/O1), U2.6 (I/O1), U3.5 (UD+)
VBAT: C11.1, C12.1, C35.1, C36.1, C37.1, C38.1, D1.1 (A1), D2.2 (A), J10.2, J11.3, J11.4, J12.3, J12.4, J13.3, J13.4, J14.2, J15.3, J15.4, J16.2, Q1.1 (S), Q1.2 (S), Q1.3 (S), R6.1, R7.1
VBAT_SENSE: C13.1, R7.2, R8.1, U1.22 (ADC7)
VBUCK: C14.1, C15.1, C16.1, D2.1 (K), R11.1, U5.3 (VIN)
VBUS: C9.1, F1.1, J2.A4 (VBUS), J2.A9 (VBUS), J2.B4 (VBUS), J2.B9 (VBUS), U2.5 (VBUS)
VBUS_F: C10.1, F1.2, U4.1 (VIN)

Notes on the sheet:
ATmega328P-AU, 16 MHz, reset + ICSP
USB-C, CH340C, DTR auto-reset, USB to 5 V only
2S battery: reverse-polarity FET, TVS, servo-rail bulk
5 V / 3 A buck (TPS563201)
3.3 V LDO (XC6206)
I2C 5 V / 3.3 V bridge (PCA9306)
PCA9685 servo PWM, 0x40
MPU-6050 IMU, 0x68
AT24C64 EEPROM, 0x54
Piezo buzzer (D5)
IR receiver (D4)
NeoPixel (D10)
Status LED (D3)
5 V power LED
Grove G1: I2C (3.3 V)
Grove G2: A2 / A3
Grove G3: D8 / D9
Grove G4: D6 / D7
6-pin serial socket (BT / WiFi dongle)
Raspberry Pi 2x5 (Pi pins 1-10)
Servo: tail (ch 4)
Servos: right hind knee (ch 7), hip (ch 6)
Servos: left hind hip (ch 1), knee (ch 0)
Servos: right front shoulder (ch 9), knee (ch 8)
Servo: head tilt (ch 11)
Servos: left front knee (ch 15), shoulder (ch 14)
Servo: head pan (ch 12)
Mounting hole (58 x 49 mm pattern)
Power flags

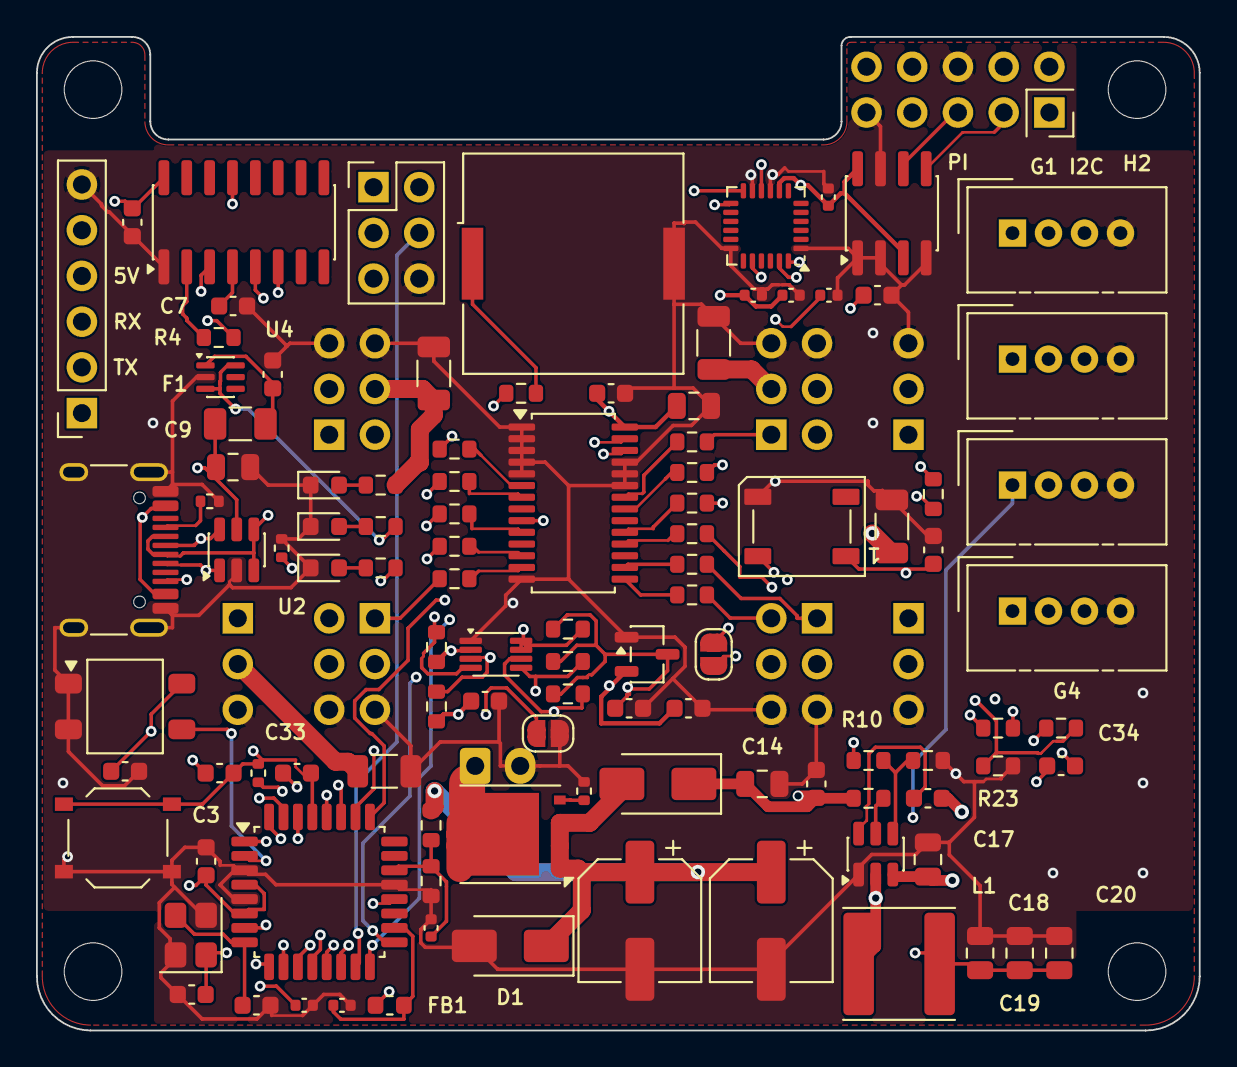
[picture p18: board whisker.kicad_pcb from above]

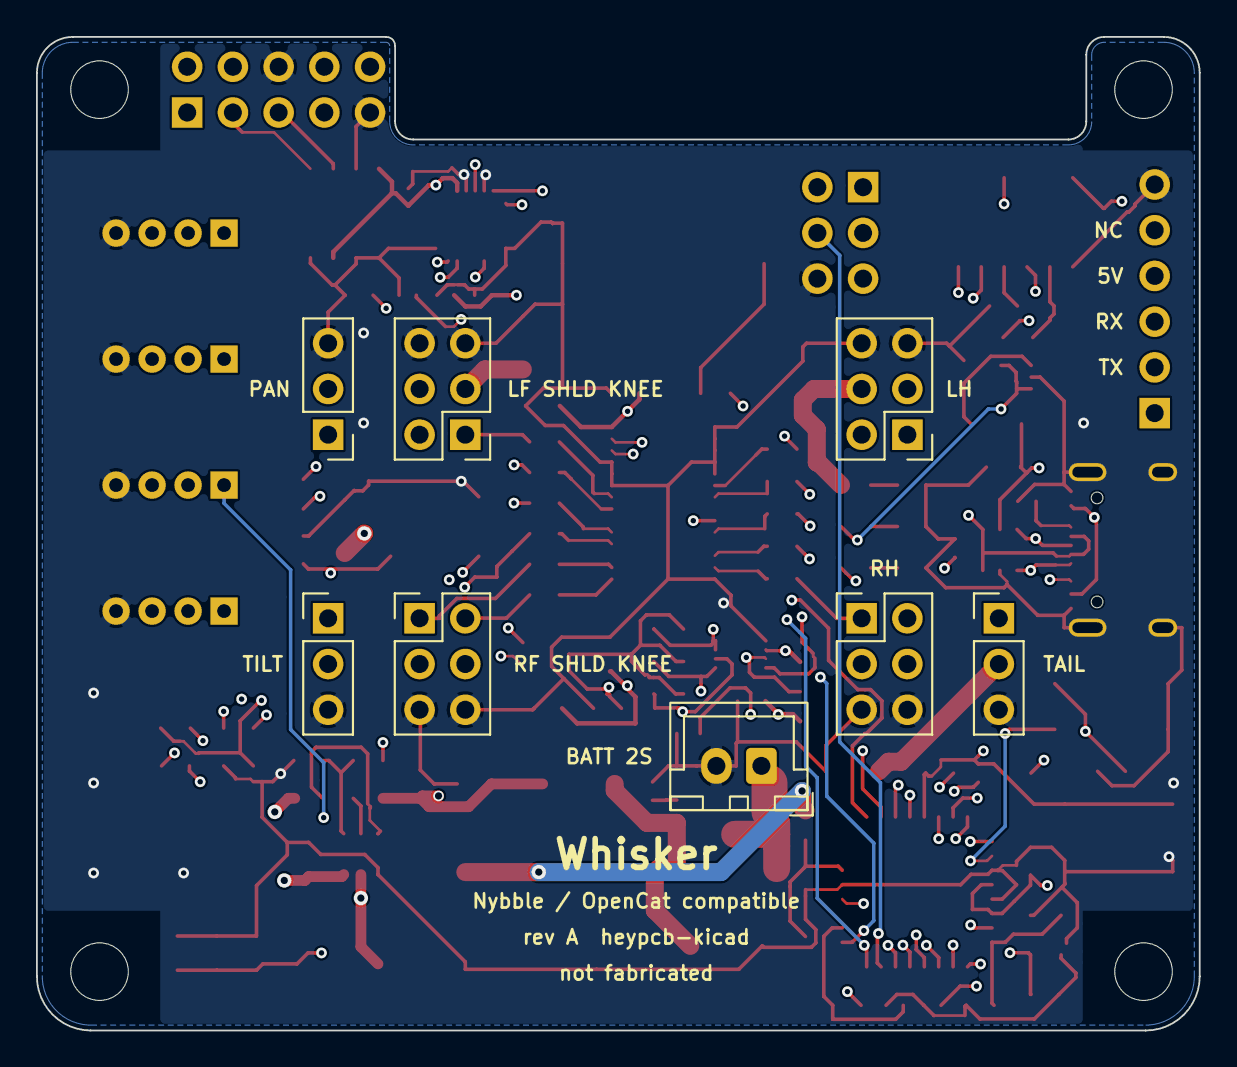
[picture p19: board whisker.kicad_pcb from below]

Board: 4 copper layers, 64.6 x 55.2 mm, 118 parts (8 on the bottom side), 81 nets.
